SmallCoral/FluxDial/docs/README.md

# FluxDial 文档

本目录维护当前工程的说明，基于源码与 KiCad 文件核对。
原厂资料和既有报告仍保存在 [Documentation](../Documentation/README.md)。

| 文档 | 用途 | 主要依据 |
| --- | --- | --- |
| [上手](getting-started.md) | 接线、编译、烧录与使用步骤 | 构建、测试和烧录脚本 |
| [系统架构](architecture.md) | 数据流与模块职责 | 主循环、BSP、应用层和原理图层次页 |
| [硬件参考](hardware.md) | 电源、器件、接口与引脚的唯一维护表 | 当前原理图、PCB 焊盘网络和本地手册 |
| [固件参考](firmware.md) | 采样、阈值、状态码和诊断变量的唯一维护表 | 当前产品固件 |
| [验证记录](validation.md) | 当前检查、历史实测与未验证事项 | 本轮执行结果及既有实测记录 |
| [许可证与第三方资料](licenses.md) | 项目授权现状和第三方文件位置 | 仓库现有许可证及文件头 |
| [本轮审查](documentation-audit-2026-10-29.md) | 审查范围、逐文件结论及验证结果 | 最终文档复审 |

这些页面按操作指南、架构说明和事实参考分工，避免重复维护参数。
旧文档路径保留入口；原厂 PDF、历史网表、BOM 和检查脚本没有随本轮文档整理改写。

[返回项目首页](../README.md)。
