SmallCoral/FluxDial/docs/documentation-audit-2026-10-29.md

# 文档编写与审查记录

审查日期为 **2026-10-29**，工程基线为 `953b748`。
开始时本地工作区干净，GitHub `master` 与本地提交一致。
本轮使用 [mthines/agent-skills 的 docs Skill](https://github.com/mthines/agent-skills/blob/2b8d75d325c4816c4c1f5f3e982f682442b79c5d/skills/authoring/docs/SKILL.md)，依次执行审计、编写及第二轮复审。

## 检查范围与依据

检查了仓库结构、产品固件、Makefile、PowerShell 脚本、CI、五页原理图、PCB、项目库、照片、视频、器件 PDF、既有 Markdown 和许可证。
原理图与 PCB 的接口对应同时使用当前网表、焊盘网络和固件 GPIO 配置核对。
媒体检查包括直接查看照片、规格书预览以及读取视频文件元数据。
芯片参数核对本地原厂 PDF；阻温表逐点对照厂商 Rnor 列，按整数欧姆取整核验。

本轮没有更改源代码、硬件文件、BOM、项目配置、历史 JSON 或第三方许可证正文。
临时检查导出没有覆盖既有报告。
没有新烧录目标板、接入水路或重复历史实测。

## 主要发现与处理

| 级别 | 原问题 | 本轮处理 |
| --- | --- | --- |
| P0 | 归档 BOM、图页说明文字与当前晶振电容器件值不一致 | 在 [硬件参考](hardware.md#mcu-电源与时钟)明示差异，列为装配待确认项 |
| P0 | 原始 HEVC 视频被描述为 120fps，文件元数据不能支持该断言 | 删除未经证实的帧率说明，保留原文件 |
| P0 | 历史实板记录与当前静态检查容易混淆 | 保留历史正文，增加日期与范围说明，另写 [当前验证](validation.md) |
| P1 | 首页和多份说明重复维护接口与参数 | 接口和硬件值归 [硬件参考](hardware.md)，软件配置归 [固件参考](firmware.md) |
| P1 | 缺少完整的首次接线、编译、烧录和使用路径 | 增加 [上手文档](getting-started.md)，注明实际执行与未执行的步骤 |
| P1 | 没有项目级许可证，第三方许可范围未说明 | 增加 [许可证说明](licenses.md)，保留现有第三方原文 |
| P2 | README 过长且设计细节分散 | 首页改为概览、状态和导航，旧路径保留跳转入口 |

## 逐文件复审

PASS 表示本轮按该页职责完成核对，不能解释为该页涉及的硬件已经通过实测。
WARN 表示页面如实保留了尚未验证或待确认的内容。
N/A 表示不执行编辑性改写，但确认文件及原文未被修改。

| 文件 | 结论 | 修改或复审结果 |
| --- | --- | --- |
| [README.md](../README.md) | PASS | 重写入口，补充状态、目录、使用入口和许可证边界 |
| [docs/README.md](README.md) | PASS | 新增详细文档索引与职责分工 |
| [docs/architecture.md](architecture.md) | PASS | 新增系统框图、原理图分工和源码分层 |
| [docs/hardware.md](hardware.md) | WARN | 集中器件与接口表，保留装配与资料差异 |
| [docs/firmware.md](firmware.md) | PASS | 按实际源码核对换算、周期、阈值、状态与诊断字段 |
| [docs/getting-started.md](getting-started.md) | WARN | 新增可复现步骤；实板烧录和水路操作明确未重测 |
| [docs/validation.md](validation.md) | WARN | 记录本次结果、历史边界与仍需人工确认的事项 |
| [docs/licenses.md](licenses.md) | WARN | 记录项目级许可证缺失及第三方授权边界 |
| [本文](documentation-audit-2026-10-29.md) | PASS | 记录范围、差异、复审和交付边界 |
| [Hardware/README.md](../Hardware/README.md) | PASS | 改为 KiCad 工程与硬件文档入口 |
| [Firmware/README.md](../Firmware/README.md) | PASS | 改为固件代码与操作文档入口 |
| [Images/README.md](../Images/README.md) | PASS | 核对媒体，澄清演示用途与视频信息 |
| [Documentation/README.md](../Documentation/README.md) | PASS | 改为器件资料、历史报告与旧文档导航 |
| [Documentation/DESIGN_NOTES.md](../Documentation/DESIGN_NOTES.md) | PASS | 保留旧路径，详细内容迁入硬件参考 |
| [Documentation/C562_MIGRATION.md](../Documentation/C562_MIGRATION.md) | PASS | 保留最小系统与原厂资料入口 |
| [Documentation/HSE_FOOTPRINT_A2.md](../Documentation/HSE_FOOTPRINT_A2.md) | PASS | 保留当前尺寸表与历史封装图入口 |
| [Documentation/Reports/README.md](../Documentation/Reports/README.md) | PASS | 说明历史导出与旧检查脚本的版本边界 |
| [历史实板记录](../Documentation/Reports/firmware/VALIDATION.md) | WARN | 正文保留，仅添加历史范围提示 |
| [官方资料包说明](../Documentation/Datasheets/STM32C562CET6_2026-09-16/00_README_中文.md) | PASS | 添加当前文档入口，标明既有项目摘要的归档性质 |
| [驱动来源说明](../Firmware/Drivers/README.md) | PASS | 保留来源，修正链接脚本所在目录并补充许可入口 |
| [CMSIS 许可证](../Firmware/Drivers/CMSIS/LICENSE.md) | N/A | 原文及文件哈希未变 |
| [器件头文件许可证](../Firmware/Drivers/CMSIS/Device/ST/STM32C5xx/LICENSE.md) | N/A | 原文及文件哈希未变 |
| [LL 驱动许可证](../Firmware/Drivers/STM32C5xx_LL_Driver/LICENSE.md) | N/A | 原文及文件哈希未变 |

## 验证结果

复审以最终文档重新逐项核对，和首轮调查分开进行。
自动化检查使用 Markdown 解析器提取链接和标题，检查实际路径、大小写、锚点与图片引用。
没有将源码中某个常量存在等同于功能已经完成实测。

| 项目 | 结果 |
| --- | --- |
| Markdown 覆盖 | 23 个文件，包括 3 份保持原文的第三方许可证 |
| 链接与图片 | 248 处本地链接通过，包含 32 处 Markdown 锚点和 5 处图片引用；路径大小写同时核对 |
| 外部链接 | 原厂及 GitHub 入口已尝试访问；Arm 下载页重定向后要求 JavaScript 人机验证，未能自动核实下载内容 |
| 接口与 MCU | 20 项外部接口/关键 MCU 网络同时对照原理图和 PCB |
| 显示矩阵 | 10 条段线和 6 条 COM 连接与网表一致 |
| 阻温表 | 136 个 Rnor 点逐项核对，代码整数化与 PDF 标称值的差不超过 0.5Ω；这不是测量误差或精度声明 |
| 原厂资料 | 官方资料包内 8 个 PDF 的 SHA-256 与原清单一致 |
| 历史记录 | 实板记录正文保留，仅增加范围提示 |
| 文件范围 | 非 Markdown 跟踪文件与第三方许可证的哈希未变 |
| 构建与测试 | 强制 ARM 构建、现有主机测试通过，数值与覆盖见 [验证记录](validation.md) |

Makefile 的主机测试目标也在 Windows GNU Make、sh 和 TCC 组合下实际执行通过。
本轮没有单独启动 Linux 环境，因此 Linux 平台的本次运行情况不作通过声明。

没有添加代码或硬件检查的 CI 配置。
现有 CI 面向固件，不包含文档链接、术语或行文检查；本轮验证是一次本地审查。
未添加发布版本、整体许可证或整板合格状态徽章，以免制造仓库中不存在的发布或验证信息。

## 仍需人工确认

当前 DRC、实际装配、电源带载、通水与精度标定、长期运行及材料授权仍需处理。
详细清单只在 [验证记录](validation.md#仍需人工确认)维护。
本轮没有将文档编辑扩大为电路修订或替作者选择许可证。

## 优先处理的三项后续工作

1. 核对实际装配与当前工程，处理归档物料差异和当前 ERC/DRC 项。
2. 在真实水路与参考仪器下补齐温度、流量和电源验证记录。
3. 由作者明确项目自身及所分发材料的授权范围。
