SmallCoral/FluxDial/Documentation/C562_MIGRATION.md

# STM32C562 最小系统说明入口

当前 MCU 电源、VCAP、HSE、启动与复位连接见 [硬件参考](../docs/hardware.md#mcu-电源与时钟)。
接口和引脚对应关系见 [接口表](../docs/hardware.md#接口与-mcu-引脚)，时钟软件配置见 [固件参考](../docs/firmware.md#采样与调度)。

参考资料保留在 [DS14927](Datasheets/STM32C562xx_DS14927_Rev2.pdf)、[AN6274](Datasheets/AN6274_STM32C5_Hardware_Rev1.pdf)和 [ES0661](Datasheets/ES0661_STM32C562_Rev1.pdf)。
已完成和待完成的实板验证统一见 [验证记录](../docs/validation.md#历史实板记录)。
