SmallCoral/FluxDial/Documentation/HSE_FOOTPRINT_A2.md

# 晶振与封装说明入口

当前 HSE 器件值和装配差异见 [MCU 电源与时钟](../docs/hardware.md#mcu-电源与时钟)。
MCU、晶振和圆屏的库尺寸见 [PCB 与封装](../docs/hardware.md#pcb-与封装)。

历史核对文件保留在原位置。

- [MCU 尺寸图](Reports/hardware-review/mcu_footprint_dimensioned.pdf)
- [MCU 3D 预览](Reports/hardware-review/mcu_footprint_3d.png)
- [MCU 焊盘核对表](Reports/hardware-review/STM32C562CET6_焊盘引脚核对.csv)
- [圆屏 1:1 对位图](Reports/hardware-review/display_footprint_1to1.pdf)
- [屏幕外形与矩阵](../Images/reference/display-spec-mechanics-and-matrix.png)

这些历史导出没有在本轮重新生成。
