SmallCoral/FluxDial/Documentation/Reports/hardware-review/STM32C562CET6_焊盘引脚核对.csv

脚号 | 引脚名 | 网络 | 中心X(mm) | 中心Y(mm) | 焊盘X(mm) | 焊盘Y(mm)
1 | PE2 | unconnected-(U401-PE2-Pad1) | -4.25 | -2.75 | 1.2 | 0.3
2 | PC13 | USER_KEY | -4.25 | -2.25 | 1.2 | 0.3
3 | PC14-OSC32_IN | unconnected-(U401-PC14-OSC32_IN-Pad3) | -4.25 | -1.75 | 1.2 | 0.3
4 | PC15-OSC32_OUT | unconnected-(U401-PC15-OSC32_OUT-Pad4) | -4.25 | -1.25 | 1.2 | 0.3
5 | PH0-OSC_IN | /STM32C562 最小系统/HSE_IN | -4.25 | -0.75 | 1.2 | 0.3
6 | PH1-OSC_OUT | /STM32C562 最小系统/HSE_OUT | -4.25 | -0.25 | 1.2 | 0.3
7 | NRST | MCU_NRST | -4.25 | 0.25 | 1.2 | 0.3
8 | VREF- | GND | -4.25 | 0.75 | 1.2 | 0.3
9 | VREF+ | +3V3 | -4.25 | 1.25 | 1.2 | 0.3
10 | PA0 | NTC_ADC | -4.25 | 1.75 | 1.2 | 0.3
11 | PA1 | FLOW_PULSE | -4.25 | 2.25 | 1.2 | 0.3
12 | PA2 | unconnected-(U401-PA2-Pad12) | -4.25 | 2.75 | 1.2 | 0.3
13 | PA3 | unconnected-(U401-PA3-Pad13) | -2.75 | 4.25 | 0.3 | 1.2
14 | PA4 | unconnected-(U401-PA4-Pad14) | -2.25 | 4.25 | 0.3 | 1.2
15 | PA5 | unconnected-(U401-PA5-Pad15) | -1.75 | 4.25 | 0.3 | 1.2
16 | PA6 | unconnected-(U401-PA6-Pad16) | -1.25 | 4.25 | 0.3 | 1.2
17 | PA7 | unconnected-(U401-PA7-Pad17) | -0.75 | 4.25 | 0.3 | 1.2
18 | PB0 | unconnected-(U401-PB0-Pad18) | -0.25 | 4.25 | 0.3 | 1.2
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
