SmallCoral/FluxDial/Documentation/DESIGN_NOTES.md

# 硬件设计说明入口

详细内容已集中到 [硬件参考](../docs/hardware.md)。
系统框图和软件分层见 [系统架构](../docs/architecture.md)，当前检查结果见 [验证记录](../docs/validation.md)。

本路径保留用于兼容已有链接，电源、接口、器件值和显示矩阵只在新页面维护。
