SmallCoral/FluxDial/(list of files, drawings)

Other design files:
Documentation/Reports/hardware-review/pcb_checks.json
